UM-Battery-Control-Group/LDC_Dual_Can/README.md

# LDCquadCan
 can based LDC sensor

 Forgot to tie boot0 to ground so need to set nboot option in cube programmer
