UM-Battery-Control-Group/LDC_Dual_Can/GMJuly2022_CELL012_Test1_1_P25C_5P0PSI_20240211_R0_CH001.csv

Start Time: 1707704791028
Format Version: 3.0
Timezone: America/New_York
Channel Number: 1
[DATA START]
Datapoint Number | Test Time | Current | Potential | Timestamp | LDC SENSOR | LDC REF | Ambient Temperature | Ambient RH | LDC N | LDC STD | REF N | REF STD | LDC scaled | LDC status | REF status | DriveCurrent | DriveCurrentRef | NAHwarn | NAHwarnRef
none | second | amp | volt | epoch | none | none | celsius | percent | none | none | none | none | none | none | none | none | none | none | none
2 | 7.433 | 0 | 0 | 1707704798461 | 2418136 | 0 | 24.12 | 35.42 | 50 | 294 | 0 | 0 | 0 | 0 | 0 | 5 | 0 | 0 | 0
3 | 7.809 | 0 | 0 | 1707704798837 | 2418368 | 0 | 24.14 | 35.52 | 50 | 77 | 0 | 0 | 0 | 0 | 0 | 5 | 0 | 0 | 0
4 | 9.85 | 0 | 0 | 1707704800878 | 2418447 | 0 | 24.12 | 35.82 | 49 | 16 | 0 | 0 | 0 | 0 | 0 | 5 | 0 | 0 | 0
5 | 11.889 | 0 | 0 | 1707704802917 | 2418441 | 0 | 24.12 | 35.63 | 50 | 19 | 0 | 0 | 0 | 0 | 0 | 5 | 0 | 0 | 0
6 | 13.93 | 0 | 0 | 1707704804958 | 2418435 | 0 | 24.12 | 35.13 | 50 | 22 | 0 | 0 | 0 | 0 | 0 | 5 | 0 | 0 | 0
7 | 16.01 | 0 | 0 | 1707704807038 | 2409455 | 0 | 24.12 | 34.73 | 49 | 10 | 0 | 0 | 0 | 0 | 0 | 6 | 0 | 0 | 0
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
