UM-Battery-Control-Group/LDC_Dual_Can/GMJuly2022_CELL012_Test1_1_P25C_5P0PSI_20240213_R1_CH001.csv

Start Time: 1707871133780
Format Version: 3.0
Timezone: America/New_York
Channel Number: 1
[DATA START]
Datapoint Number | Test Time | Current | Potential | Timestamp | LDC SENSOR | LDC REF | Ambient Temperature | Ambient RH | LDC N | LDC STD | REF N | REF STD | LDC scaled | LDC status | REF status | DriveCurrent | DriveCurrentRef | NAHwarn | NAHwarnRef
none | second | amp | volt | epoch | none | none | celsius | percent | none | none | none | none | none | none | none | none | none | none | none
1 | 3.056 | 0 | 0 | 1707871136836 | 2668360 | 0 | 22.99 | 33.31 | 49 | 2 | 0 | 0 | 0 | 0 | 0 | 4 | 0 | 0 | 0
2 | 8.256 | 0 | 0 | 1707871142036 | 2668360 | 0 | 23.01 | 33.42 | 47 | 2 | 0 | 0 | 0 | 0 | 0 | 4 | 0 | 0 | 0
3 | 13.357 | 0 | 0 | 1707871147137 | 2668362 | 0 | 22.99 | 33.42 | 49 | 2 | 0 | 0 | 0 | 0 | 0 | 4 | 0 | 0 | 0
4 | 18.457 | 0 | 0 | 1707871152237 | 2668363 | 0 | 23.00 | 33.31 | 48 | 2 | 0 | 0 | 0 | 0 | 0 | 4 | 0 | 0 | 0
5 | 23.557 | 0 | 0 | 1707871157337 | 2668363 | 0 | 22.99 | 33.22 | 50 | 2 | 0 | 0 | 0 | 0 | 0 | 4 | 0 | 0 | 0
6 | 28.656 | 0 | 0 | 1707871162436 | 2668364 | 0 | 22.99 | 33.22 | 48 | 2 | 0 | 0 | 0 | 0 | 0 | 4 | 0 | 0 | 0
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
