UM-Battery-Control-Group/LDC_Dual_Can/GMJuly2022_CELL012_Test1_1_P25C_5P0PSI_20240215_R0_CH001.csv

Start Time: 1708018201816
Format Version: 3.0
Timezone: America/New_York
Channel Number: 1
[DATA START]
Datapoint Number | Test Time | Current | Potential | Timestamp | LDC SENSOR | LDC REF | Ambient Temperature | Ambient RH | LDC N | LDC STD | REF N | REF STD | LDC scaled | LDC status | REF status | DriveCurrent | DriveCurrentRef | NAHwarn | NAHwarnRef
none | second | amp | volt | epoch | none | none | celsius | percent | none | none | none | none | none | none | none | none | none | none | none
1 | 2.364 | 0 | 0 | 1708018204180 | 2669191 | 0 | 22.96 | 33.61 | 49 | 1 | 0 | 0 | 0 | 0 | 0 | 4 | 0 | 0 | 0
2 | 7.363 | 0 | 0 | 1708018209179 | 2669192 | 0 | 22.99 | 33.51 | 50 | 1 | 0 | 0 | 0 | 0 | 0 | 4 | 0 | 0 | 0
3 | 12.364 | 0 | 0 | 1708018214180 | 2669193 | 0 | 22.97 | 33.72 | 48 | 2 | 0 | 0 | 0 | 0 | 0 | 4 | 0 | 0 | 0
4 | 17.364 | 0 | 0 | 1708018219180 | 2669194 | 0 | 23.00 | 33.61 | 50 | 1 | 0 | 0 | 0 | 0 | 0 | 4 | 0 | 0 | 0
5 | 22.46 | 0 | 0 | 1708018224276 | 2669197 | 0 | 23.00 | 33.42 | 50 | 2 | 0 | 0 | 0 | 0 | 0 | 4 | 0 | 0 | 0
6 | 27.46 | 0 | 0 | 1708018229276 | 2669196 | 0 | 22.99 | 33.42 | 50 | 2 | 0 | 0 | 0 | 0 | 0 | 4 | 0 | 0 | 0
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
