UM-Battery-Control-Group/LDC_Dual_Can/Schematic.PDF

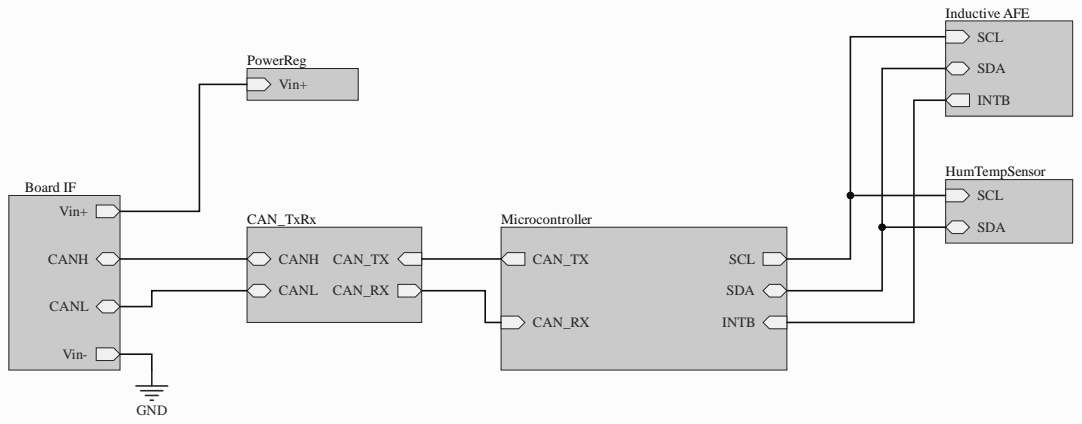
[picture p1: page 1]

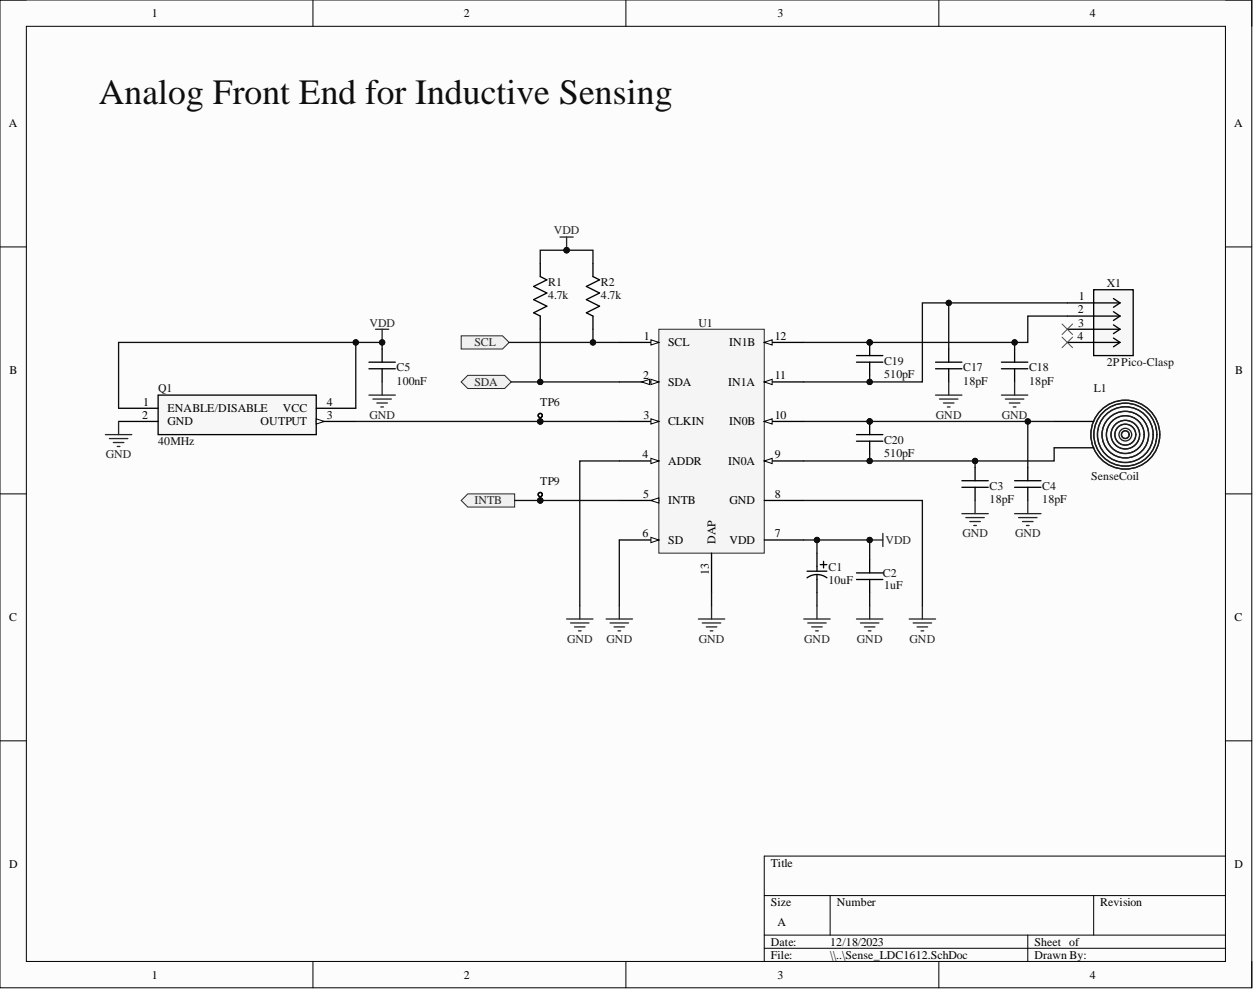
[picture p2: page 2]

Analog Front End for Inductive Sensing

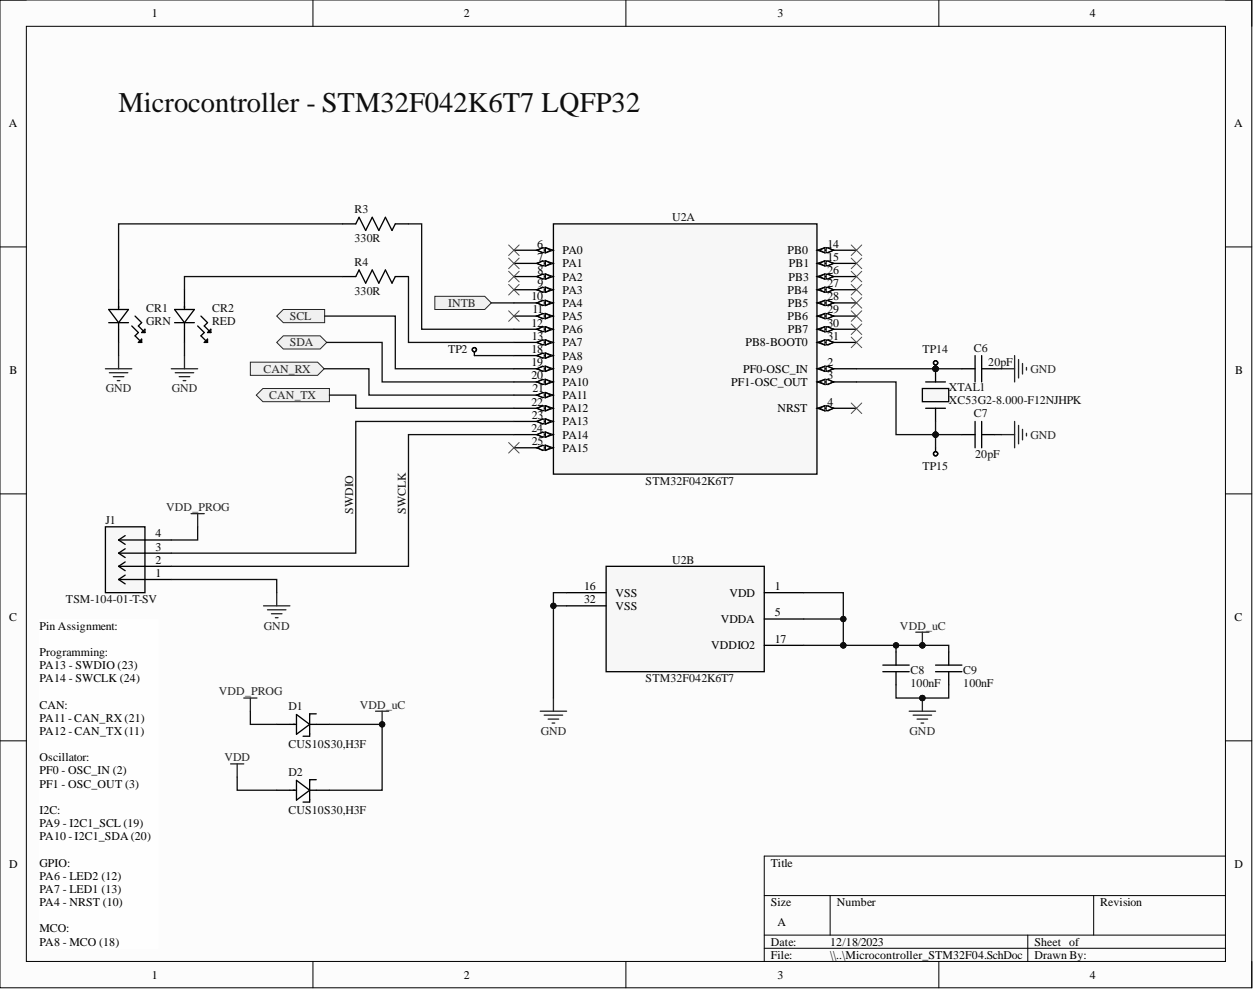
[picture p3: page 3]

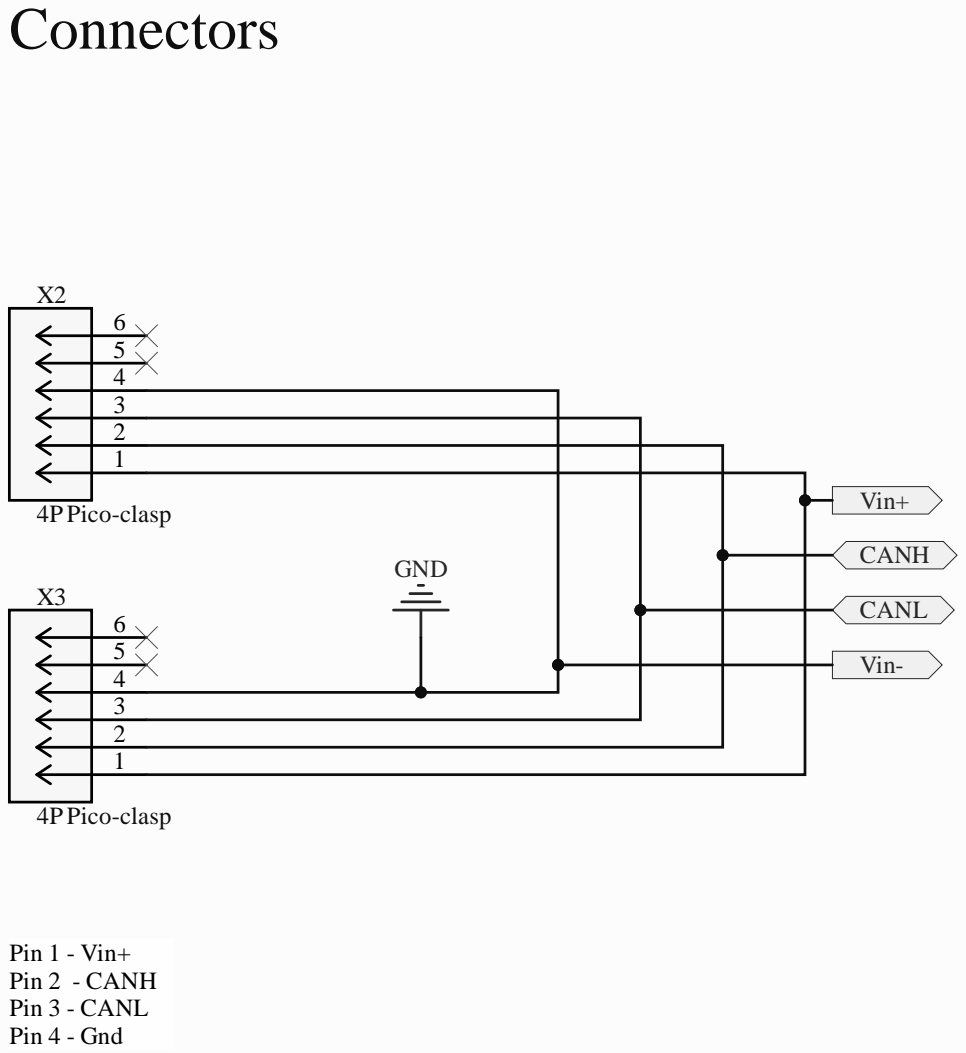
[picture p4: page 4]

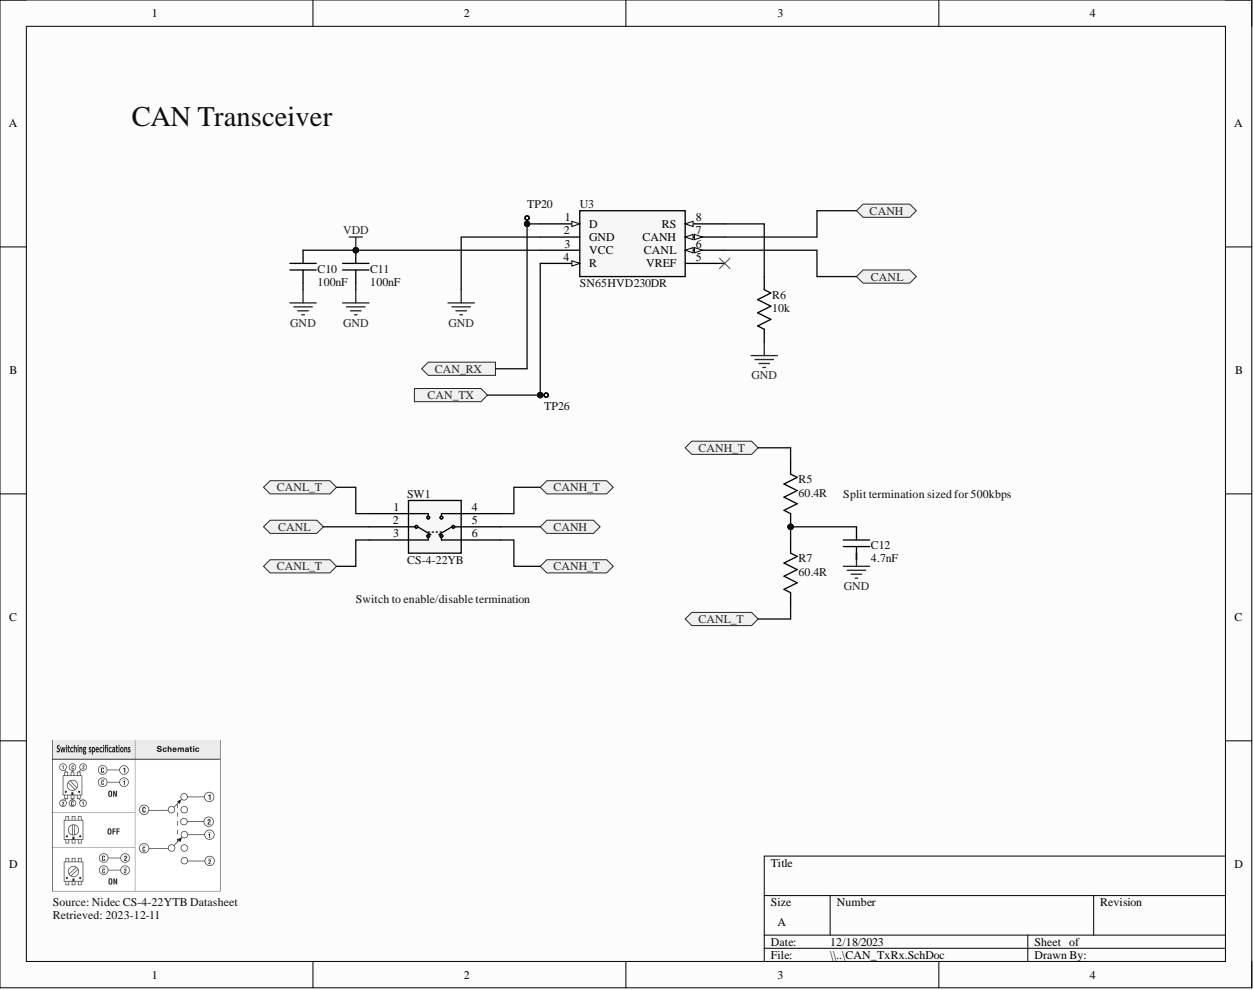
[picture p5: page 5]

Split termination sized for 500kbps

Switch to enable/disable termination

Source: Nidec CS-4-22YTB Datasheet
Retrieved: 2023-12-11

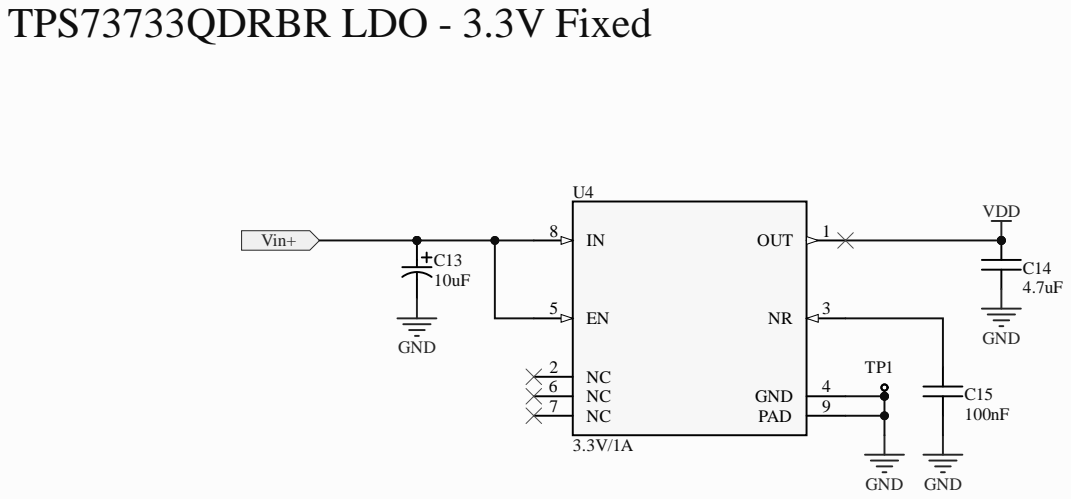
[picture p6: page 6]

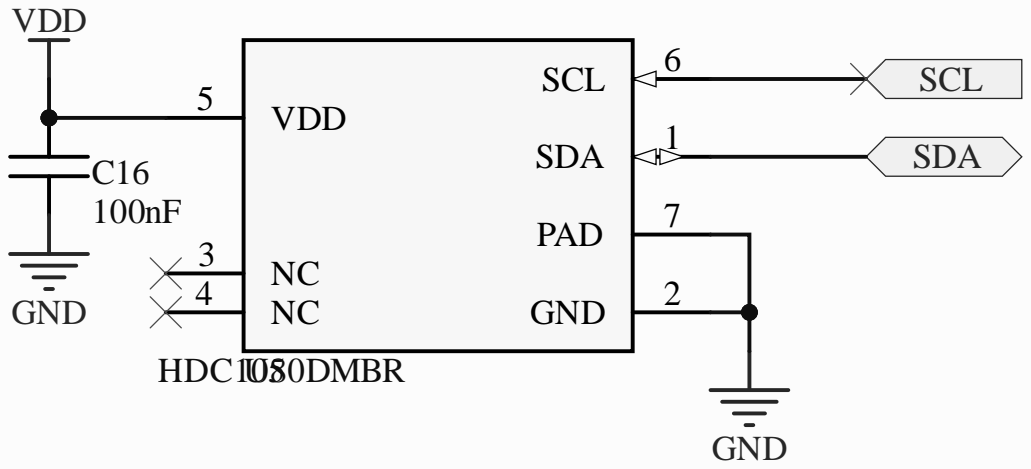
[picture p7: page 7]
