UM-Battery-Control-Group/LDC_Dual_Can/(list of files, drawings)

Other design files:
L_Sense_Board_Rev3.2/Shared_Libraries/Schlib1.SchLib
