UM-Battery-Control-Group/LDC_Dual_Can/L_Sense_Board_Rev3.2/InductiveSensor_LDC1612_Rev3.2/InductiveSensor_LDC1612_Rev3.2.kicad_pcb

## KiCad design L_Sense_Board_Rev3.2/InductiveSensor_LDC1612_Rev3.2/InductiveSensor_LDC1612_Rev3.2.kicad_pcb (2026-05-11)

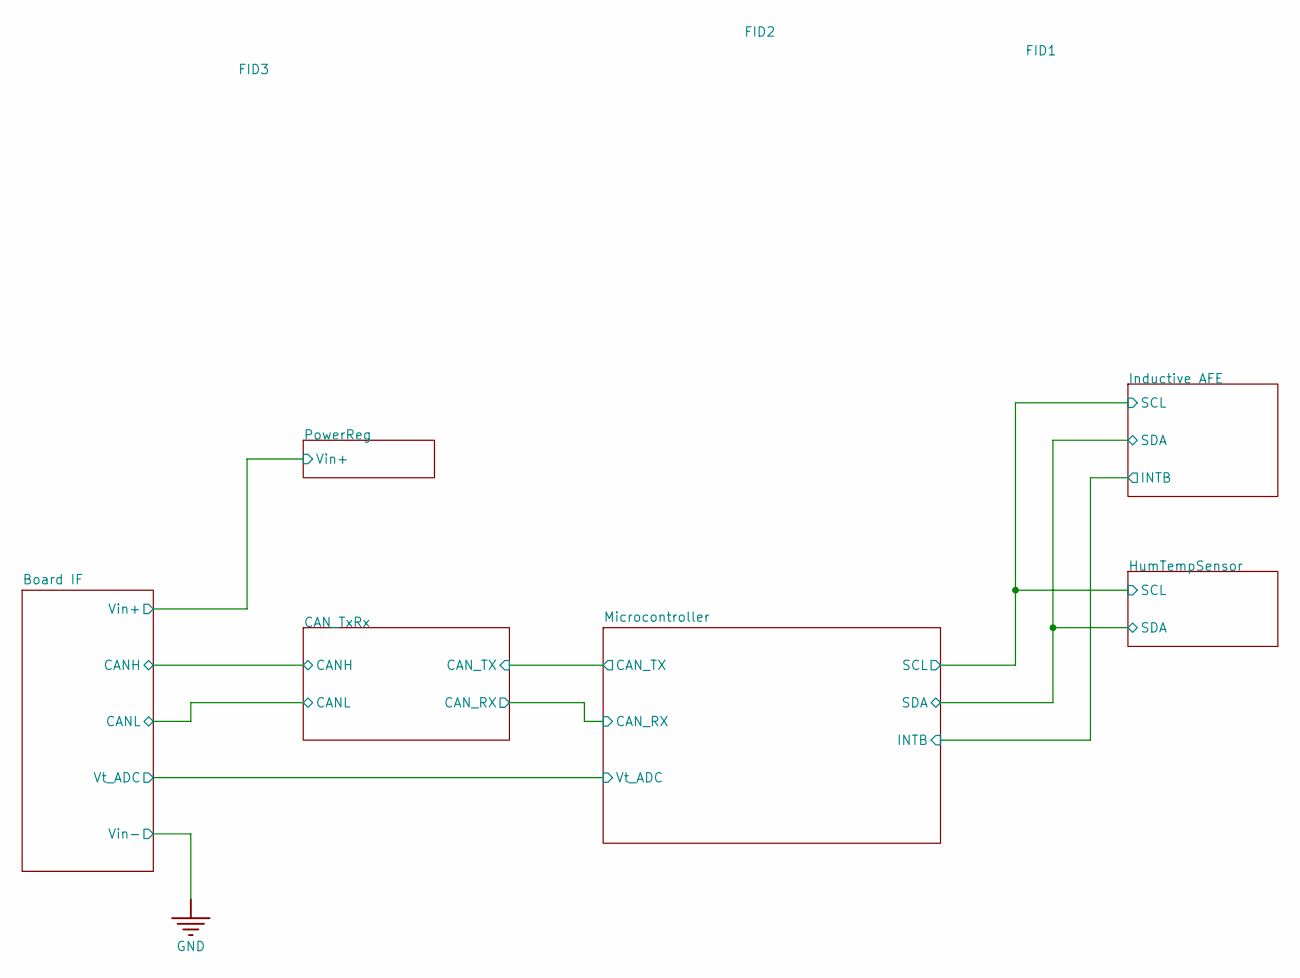
[picture p8: schematic Sheet1.kicad_sch]

Parts:
FID1, FID2, FID3: Fiducial; FID

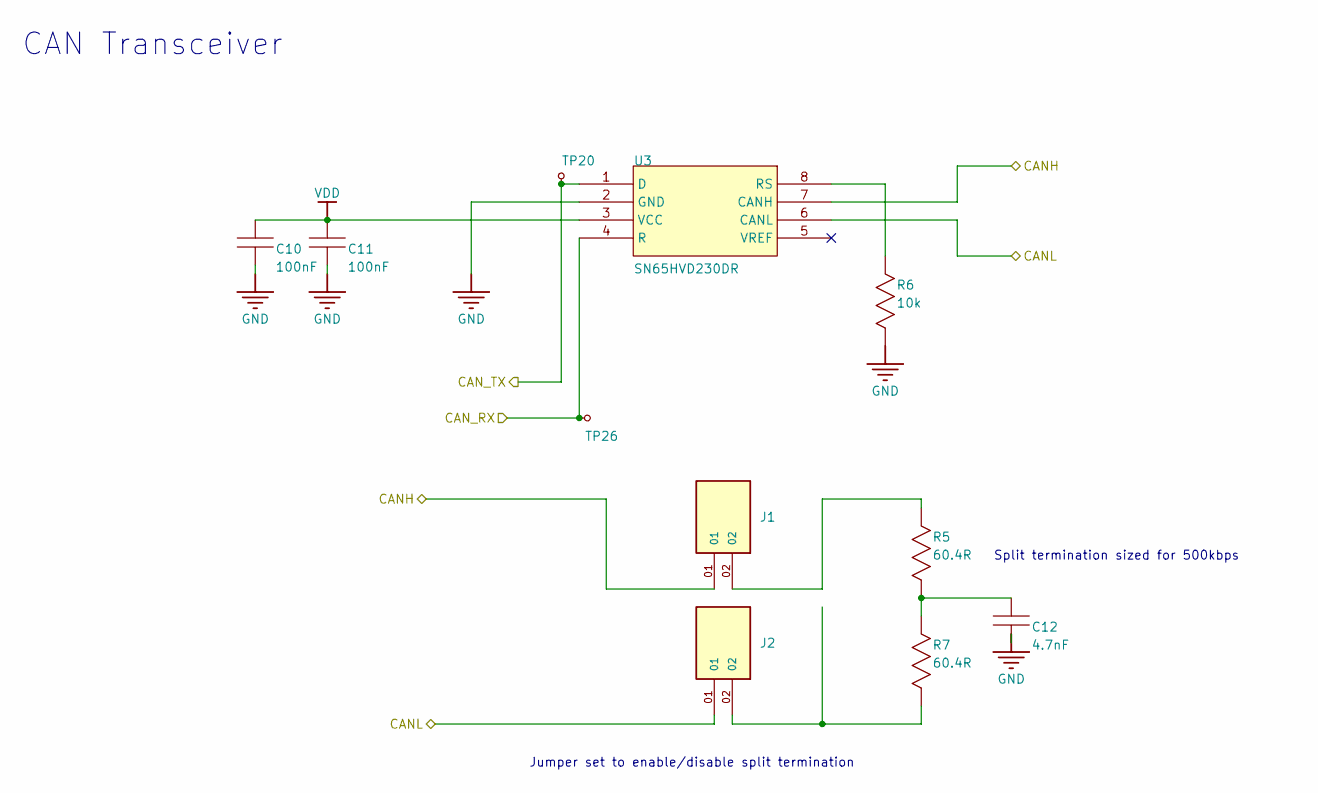
[picture p9: schematic CAN_TxRx.kicad_sch]

Parts:
C10, C11: 100nF; CAP0805; TOLERANCE 10%; VOLTAGE 50V; MANUFACTURER PART NUMBER CC0805KRX7R9BB104; LCSC PART# C49678
C12: 4.7nF; C0603; MANUFACTURER PART NUMBER C0603C472K1TACAUTO; LCSC PART# C3882427
J1, J2: TSM-102-01-X-SV; SAMTEC_TSM-102-01-X-SV; PARTREV D; DigiKey_Part_Number 612-TSM-102-01-S-SV-P-TRCT-ND
R5, R7: 60.4R; R0603; POWER RATING 100mW; TOLERANCE 1%; MANUFACTURER PART NUMBER RC0603FR-0760R4L; LCSC PART# C245987
R6: 10k; R0603; TOLERANCE 1%; VOLTAGE RATING (AC) 50V; MANUFACTURER PART NUMBER RC0603FR-0710KL; LCSC PART# C98220
TP20, TP26: 1mm Test Point; TP_1MM
U3: SN65HVD230DR; SOIC_8; MANUFACTURER PART NUMBER SN65HVD230DR; LCSC PART# C12084

Connections:
//Board IF/CANH: J1.01, U3.7 (CANH); also elsewhere on the board
//Board IF/CANL: J2.01, U3.6 (CANL); also elsewhere on the board
//CAN_TxRx/CAN_RX: TP26.1 (0), U3.4 (R); also elsewhere on the board
//CAN_TxRx/CAN_TX: TP20.1 (0), U3.1 (D); also elsewhere on the board
GND: C10.2, C11.2, C12.2, R6.2, U3.2 (GND); also elsewhere on the board
unnamed: C12.1, R5.2, R7.1
unnamed: J1.02, R5.1
unnamed: J2.02, R7.2
unnamed: R6.1, U3.8 (RS)
VDD: C10.1, C11.1, U3.3 (VCC); also elsewhere on the board

Notes on the sheet:
CAN Transceiver
Split termination sized for 500kbps
Jumper set to enable/disable split termination

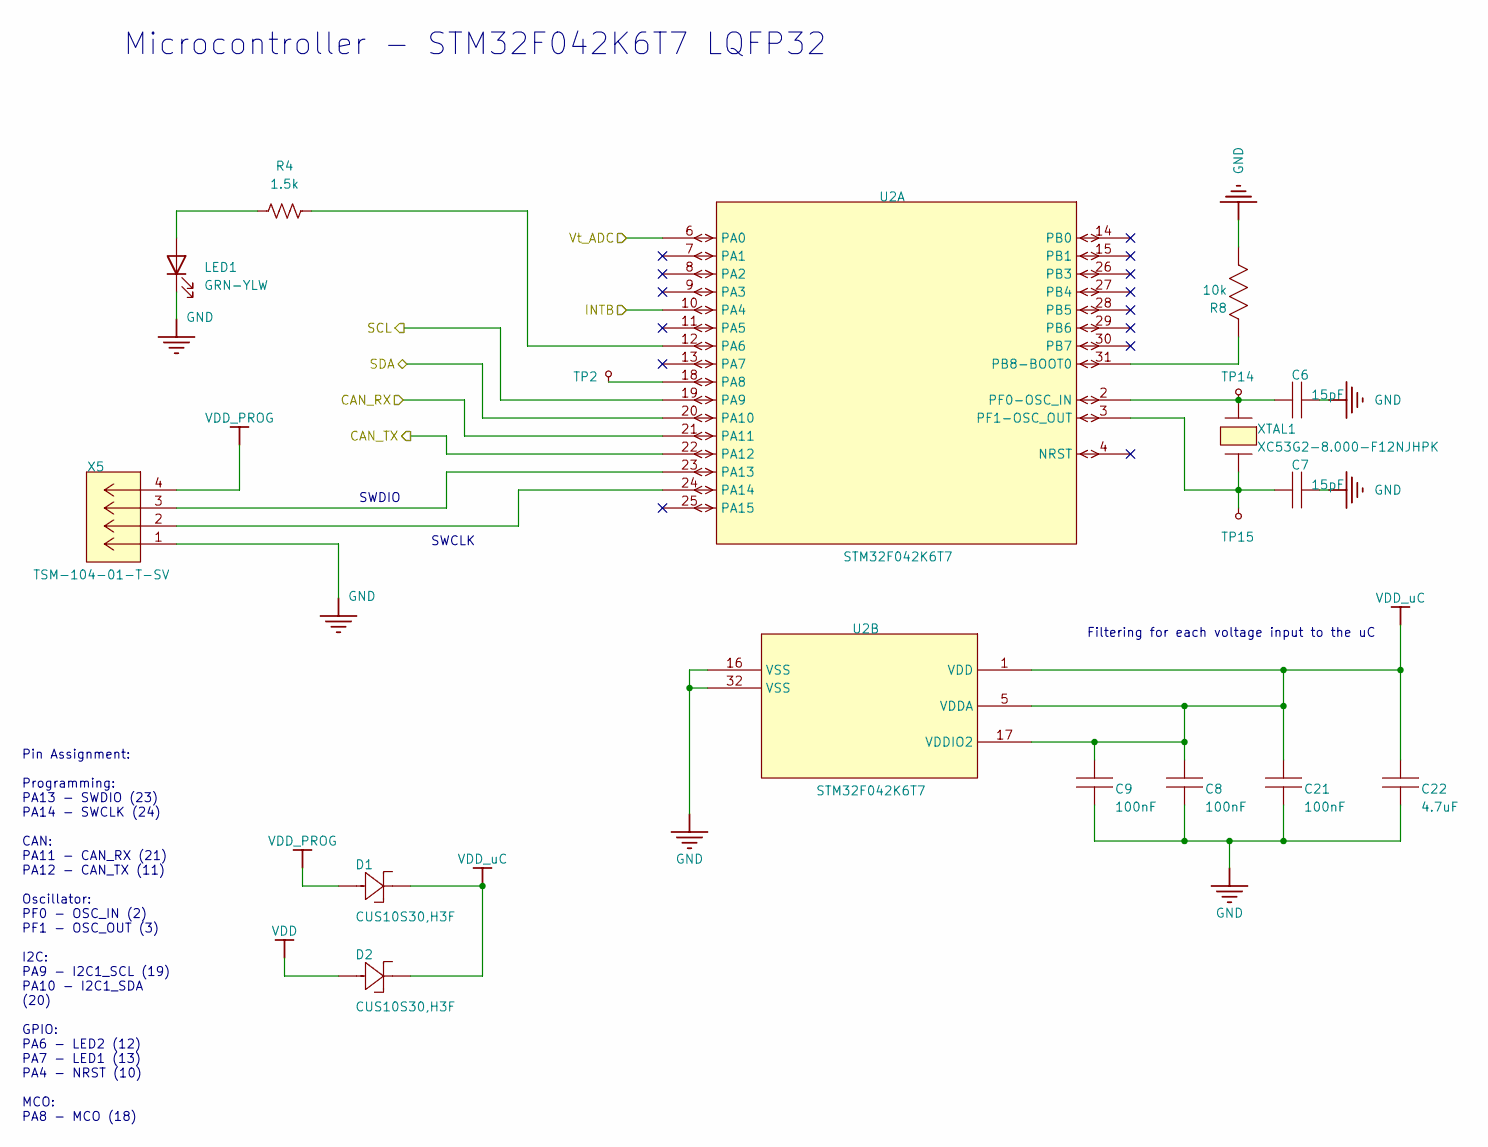
[picture p10: schematic Microcontroller_STM32F04.kicad_sch]

Parts:
C6, C7: 15pF; C0603; TOLERANCE 5%; VOLTAGE RATING 50V; MANUFACTURER PART NUMBER CL10C150JB81PNC
C8, C9, C21: 100nF; CAP0805; TOLERANCE 10%; VOLTAGE 50V; MANUFACTURER PART NUMBER CC0805KRX7R9BB104; LCSC PART# C49678
C22: 4.7uF; C_1206_3216Metric; TOLERANCE 10%; VOLTAGE 50V; MANUFACTURER PART NUMBER CC1206KFX7R9BB475
D1, D2: CUS10S30,H3F; USC_TOS; MANUFACTURER_PART_NUMBER CUS10S30,H3F; LCSC PART# C146335
LED1: GRN-YLW; LED_0603_1608Metric; MPN 5988E60107F
R4: 1.5k; R_0603_1608Metric; Part Number RC0603FR-7W1K5L
R8: 10k; R0603; TOLERANCE 1%; VOLTAGE RATING (AC) 50V; MANUFACTURER PART NUMBER RC0603FR-0710KL; LCSC PART# C98220
TP2, TP14, TP15: 1mm Test Point; TP_1MM
U2: STM32F042K6T7; LQFP-32; MANUFACTURER_PART_NUMBER STM32F042K6T7; LCSC PART# C1337340
X5: TSM-104-01-T-SV; CONN_TSM-104-01-T-SV_SAI; MAX VOLTAGE RATING (AC) 475V; FLAMMABILITY RATING UL94 V-0; MANUFACTURER_PART_NUMBER TSM-104-01-T-SV; LCSC PART# C3335977
XTAL1: XC53G2-8.000-F12NJHPK; XTAL_NX5032_NDK; MANUFACTURER_PART_NUMBER XC53G2-8.000-F12NJHPK; LCSC PART# C2842269

Connections:
//Board IF/Vt_ADC: U2.6 (PA0); also elsewhere on the board
//CAN_TxRx/CAN_RX: U2.21 (PA11); also elsewhere on the board
//CAN_TxRx/CAN_TX: U2.22 (PA12); also elsewhere on the board
//HumTempSensor/SCL: U2.19 (PA9); also elsewhere on the board
//HumTempSensor/SDA: U2.20 (PA10); also elsewhere on the board
//Inductive AFE/INTB: U2.10 (PA4); also elsewhere on the board
GND: C6.1, C7.1, C8.2, C9.2, C21.2, C22.2, LED1.1 (K), R8.2, U2.16 (VSS), U2.32 (VSS), X5.1; also elsewhere on the board
unnamed: LED1.2 (A), R4.1
unnamed: TP2.1 (0), U2.18 (PA8)
unnamed: C6.2, TP14.1 (0), U2.2 (PF0-OSC_IN), XTAL1.2
unnamed: C7.2, TP15.1 (0), U2.3 (PF1-OSC_OUT), XTAL1.1
unnamed: R4.2, U2.12 (PA6)
unnamed: U2.23 (PA13), X5.3
unnamed: U2.24 (PA14), X5.2
unnamed: R8.1, U2.31 (PB8-BOOT0)
VDD: D2.2 (anode); also elsewhere on the board
VDD_PROG: D1.2 (anode), X5.4
VDD_uC: C8.1, C9.1, C21.1, C22.1, D1.1 (cathode), D2.1 (cathode), U2.1 (VDD), U2.5 (VDDA), U2.17 (VDDIO2); also elsewhere on the board

Notes on the sheet:
SWDIO
Microcontroller - STM32F042K6T7 LQFP32
SWCLK
Filtering for each voltage input to the uC
Pin Assignment: Programming: PA13 - SWDIO (23) PA14 - SWCLK (24) CAN: PA11 - CAN_RX (21) PA12 - CAN_TX (11) Oscillator: PF0 - OSC_IN (2) PF1 - OSC_OUT (3) I2C: PA9 - I2C1_SCL (19) PA10 - I2C1_SDA (20) GPIO: PA6 - LED2 (12) PA7 - LED1 (13) PA4 - NRST (10) MCO: PA8 - MCO (18)

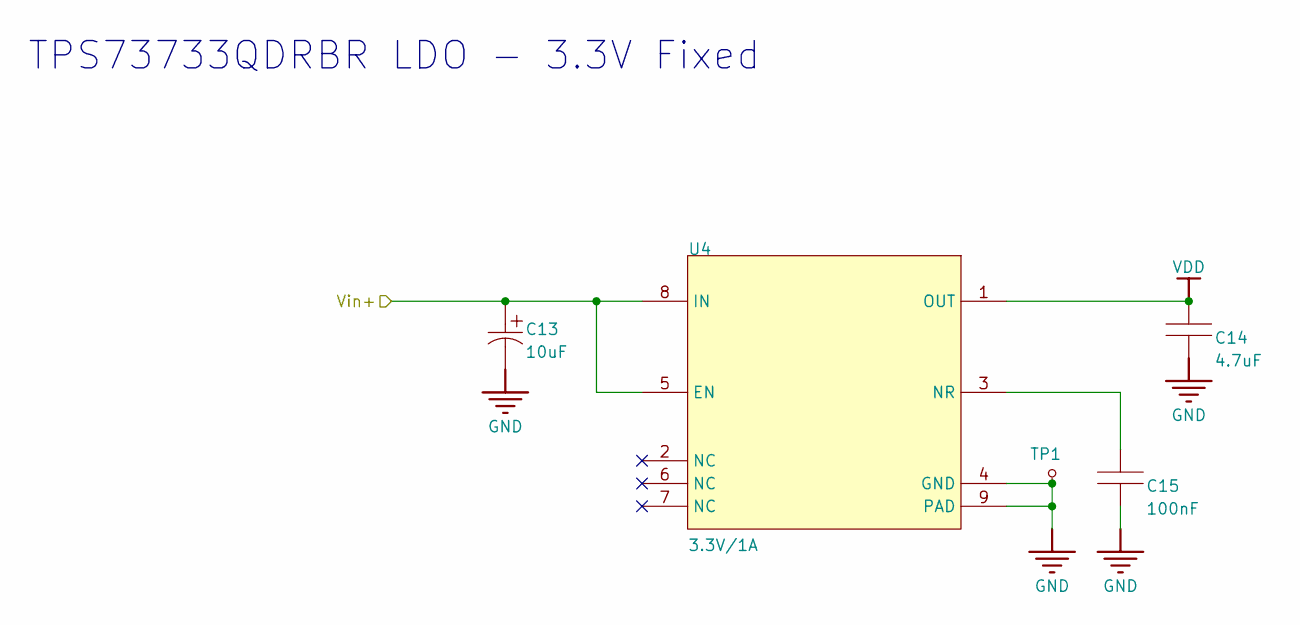
[picture p11: schematic PowerReg.kicad_sch]

Parts:
C13: 10uF; CAP1206_TAJA; TOLERANCE 10%; VOLTAGE RATING 16V; MANUFACTURER_PART_NUMBER TAJA106K016RNJ; LCSC PART# C7171
C14: 4.7uF; CAP0805; TOLERANCE 10%; VOLTAGE RATING 25V; MANUFACTURER PART NUMBER CL21A475KAQNNNE; LCSC PART# C1779
C15: 100nF; CAP0805; TOLERANCE 10%; VOLTAGE 50V; MANUFACTURER PART NUMBER CC0805KRX7R9BB104; LCSC PART# C49678
TP1: 1mm Test Point; TP_1MM
U4: 3.3V/1A; VSON_DRB8; OUTPUT VOLTAGE 3.3V; DROPOUT VOLTAGE 130mV; MANUFACTURER PART NUMBER TPS73733QDRBRQ1; LCSC PART# C523768

Connections:
//Board IF/Vin+: C13.1, U4.5 (EN), U4.8 (IN); also elsewhere on the board
GND: C13.2, C14.1, C15.2, TP1.1 (0), U4.4 (GND), U4.9 (PAD); also elsewhere on the board
unnamed: C15.1, U4.3 (NR)
VDD: C14.2, U4.1 (OUT); also elsewhere on the board

Notes on the sheet:
TPS73733QDRBR LDO - 3.3V Fixed

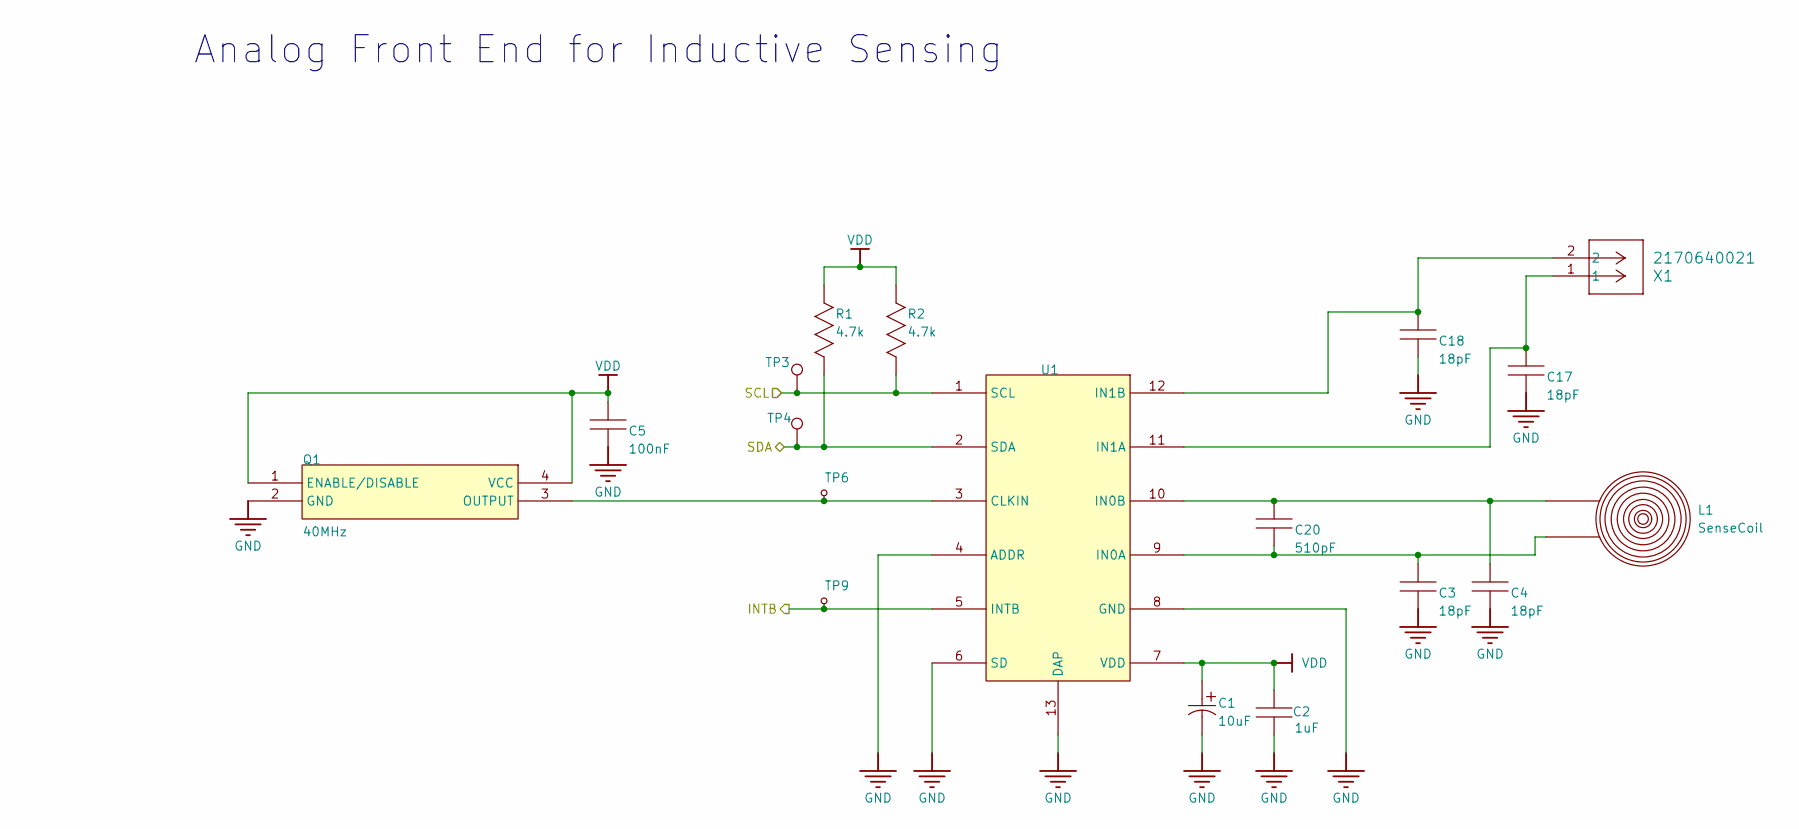
[picture p12: schematic Sense_LDC1612.kicad_sch]

Parts:
C1: 10uF; CAP1206_TAJA; TOLERANCE 10%; VOLTAGE RATING 16V; MANUFACTURER_PART_NUMBER TAJA106K016RNJ; LCSC PART# C7171
C2: 1uF; CAP0805; TOLERANCE 10%; VOLTAGE RATING 50V; MANUFACTURER PART NUMBER CL21B105KBFNNNE; LCSC PART# C28323
C3, C4, C17, C18: 18pF; CAP0805; TOLERANCE 5%; VOLTAGE RATING 50V; MANUFACTURER PART NUMBER VJ0805A180JXACW1BC; LCSC PART# C2174299
C5: 100nF; CAP0805; TOLERANCE 10%; VOLTAGE 50V; MANUFACTURER PART NUMBER CC0805KRX7R9BB104; LCSC PART# C49678
C20: 510pF; CAP0805; TOLERANCE 5%; VOLTAGE RATING (DC) 50V; MANUFACTURER PART NUMBER CC0805JRNPO9BN511; LCSC PART# C309486
L1: SenseCoil; COIL_4L
Q1: 40MHz; KC2520Z_KYO; MANUFACTURER PART NUMBER KC2520Z40.0000C15XXK; LCSC PART# C1857241
R1, R2: 4.7k; RES0805; TOLERANCE 5%; POWER RATING 125mW; MANUFACTURER PART NUMBER ERJ-6GEYJ472V; LCSC PART# C230645
TP3, TP4: TestPoint; TP_1MM
TP6, TP9: 1mm Test Point; TP_1MM
U1: Inductive Sensor 2Ch; LDC1612; MANUFACTURER PART NUMBER LDC1612DNTR; LCSC PART# C1847959
X1: 2170640021; CONN_2170630000-SD_02_MOL; MANUFACTURER PART NUMBER 2170640021

Connections:
//HumTempSensor/SCL: R2.2, TP3.1, U1.1 (SCL); also elsewhere on the board
//HumTempSensor/SDA: R1.2, TP4.1, U1.2 (SDA); also elsewhere on the board
//Inductive AFE/INTB: TP9.1 (0), U1.5 (INTB); also elsewhere on the board
GND: C1.2, C2.2, C3.2, C4.2, C5.2, C17.2, C18.2, Q1.2 (GND), U1.4 (ADDR), U1.6 (SD), U1.8 (GND), U1.13 (DAP); also elsewhere on the board
unnamed: Q1.3 (OUTPUT), TP6.1 (0), U1.3 (CLKIN)
unnamed: C3.1, C20.1, L1.1, U1.9 (IN0A)
unnamed: C4.1, C20.2, L1.2, U1.10 (IN0B)
unnamed: C17.1, U1.11 (IN1A), X1.1
unnamed: C18.1, U1.12 (IN1B), X1.2
VDD: C1.1, C2.1, C5.1, Q1.1 (ENABLE/DISABLE), Q1.4 (VCC), R1.1, R2.1, U1.7 (VDD); also elsewhere on the board

Notes on the sheet:
Analog Front End for Inductive Sensing

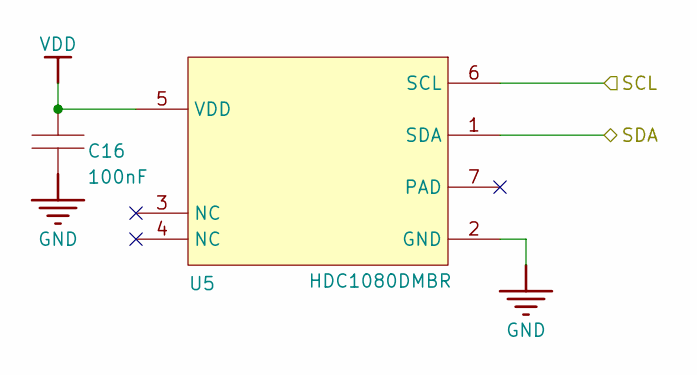
[picture p13: schematic HumTempSensor.kicad_sch]

Parts:
C16: 100nF; CAP0805; TOLERANCE 10%; VOLTAGE 50V; MANUFACTURER PART NUMBER CC0805KRX7R9BB104; LCSC PART# C49678
U5: I2C Humidity/Temp Sensor; WSON_DMB6; MANUFACTURER PART NUMBER HDC1080DMBR; LCSC PART# C82227

Connections:
//HumTempSensor/SCL: U5.6 (SCL); also elsewhere on the board
//HumTempSensor/SDA: U5.1 (SDA); also elsewhere on the board
GND: C16.2, U5.2 (GND); also elsewhere on the board
VDD: C16.1, U5.5 (VDD); also elsewhere on the board

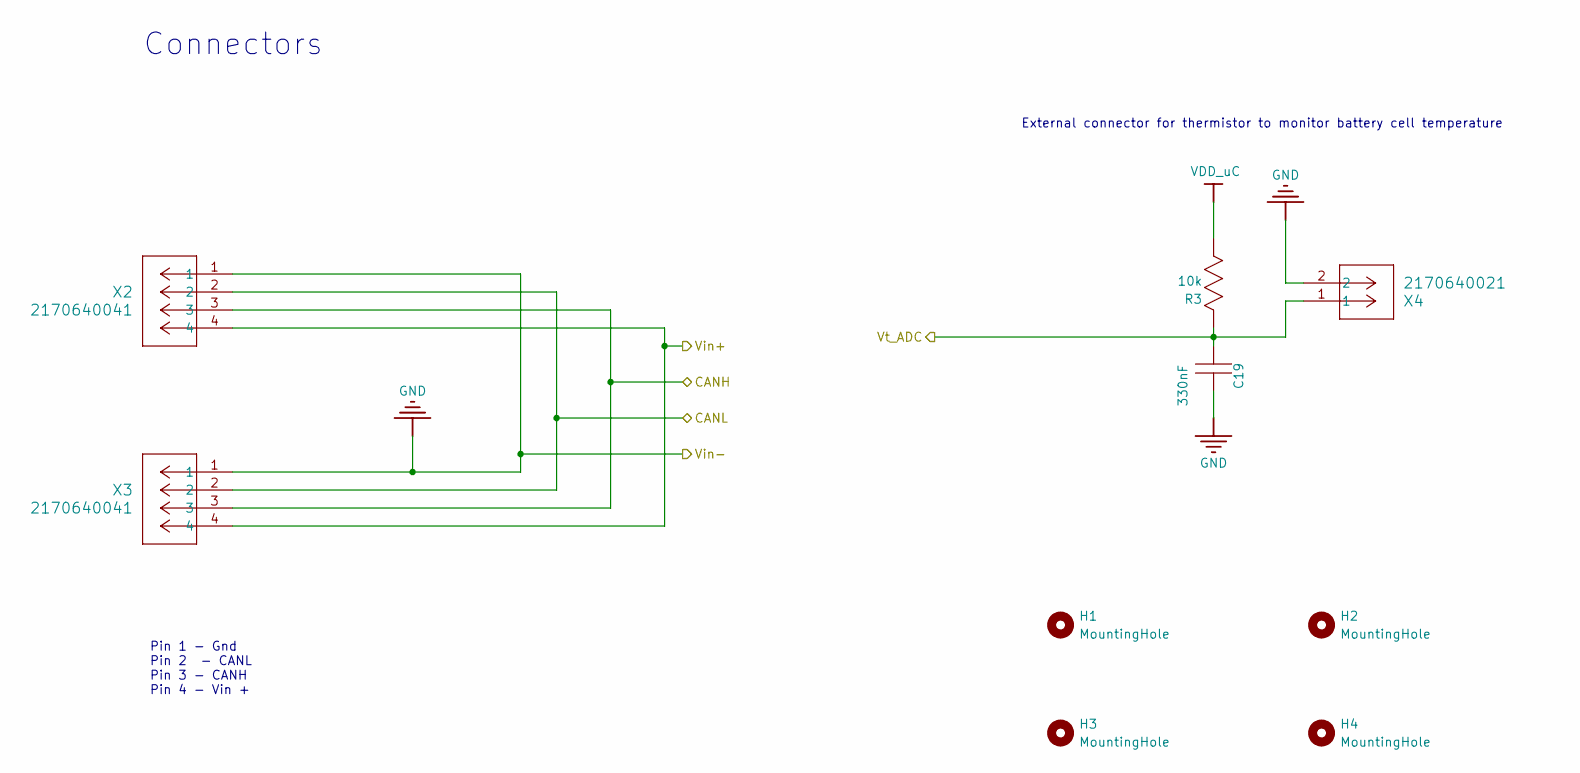
[picture p14: schematic BoardIF.kicad_sch]

Parts:
C19: 330nF; C0603; VOLTAGE RATING 50V; VOLTAGE 50V; MANUFACTURER PART NUMBER 0603B334K500XD
H1, H2, H3, H4: MountingHole; MountingHole_3.2mm_M3
R3: 10k; R0603; TOLERANCE 1%; VOLTAGE RATING (AC) 50V; MANUFACTURER PART NUMBER RC0603FR-0710KL; LCSC PART# C98220
X2, X3: 2170640041; CONN_2170630000-SD_04_MOL; MANUFACTURER PART NUMBER 2170640041
X4: 2170640021; CONN_2170630000-SD_02_MOL; MANUFACTURER PART NUMBER 2170640021

Connections:
//Board IF/CANH: X2.3, X3.3; also elsewhere on the board
//Board IF/CANL: X2.2, X3.2; also elsewhere on the board
//Board IF/Vin+: X2.4, X3.4; also elsewhere on the board
//Board IF/Vt_ADC: C19.2, R3.1, X4.1; also elsewhere on the board
GND: C19.1, X2.1, X3.1, X4.2; also elsewhere on the board
VDD_uC: R3.2; also elsewhere on the board

Notes on the sheet:
External connector for thermistor to monitor battery cell temperature
Connectors
Pin 1 - Gnd Pin 2 - CANL Pin 3 - CANH Pin 4 - Vin +

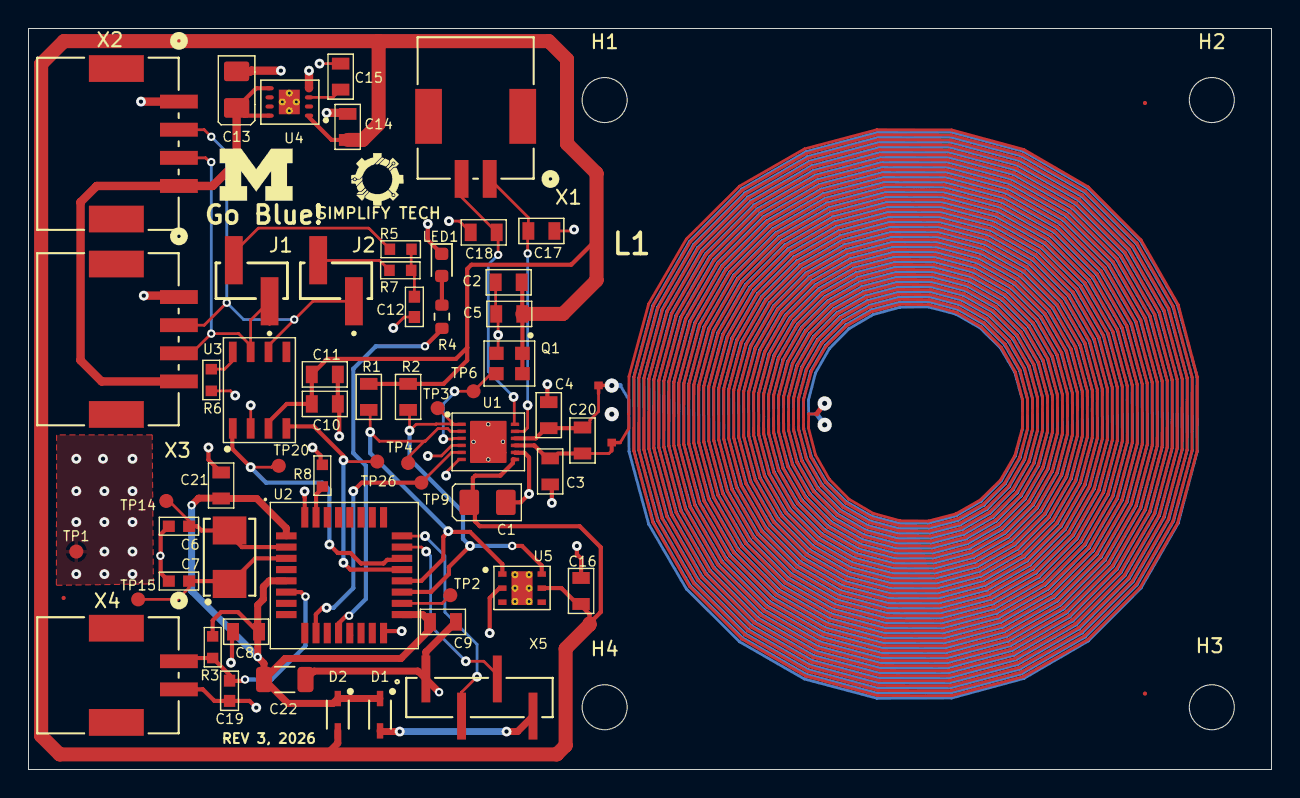
[picture p15: board InductiveSensor_LDC1612_Rev3.2.kicad_pcb from above]

Board: 4 copper layers, 88.4 x 52.7 mm, 65 parts (0 on the bottom side), 31 nets.
