UM-Battery-Control-Group/LDC_Dual_Can/L_Sense_Board_Rev3.2/Off_board_Inductor/Off_board_Inductor.kicad_pcb

## KiCad design L_Sense_Board_Rev3.2/Off_board_Inductor/Off_board_Inductor.kicad_pcb (2026-05-11)

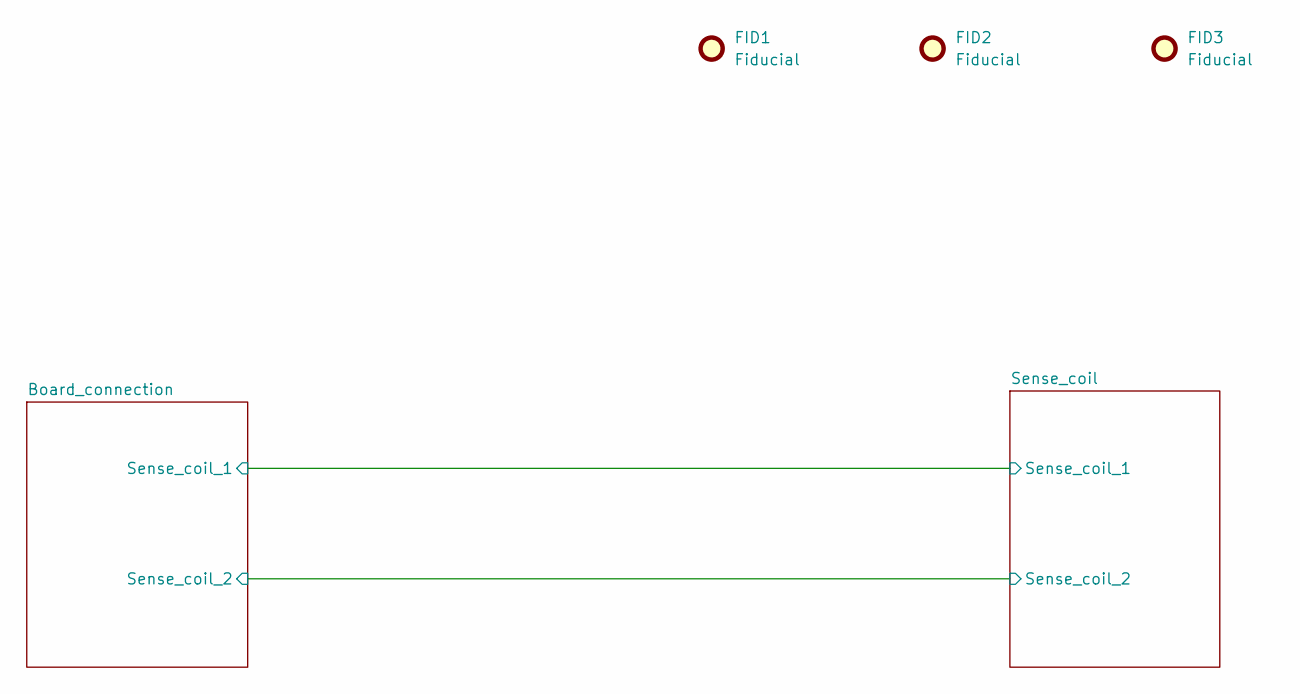
[picture p16: schematic Off_board_setup.kicad_sch]

Parts:
FID1, FID2, FID3: Fiducial; FID

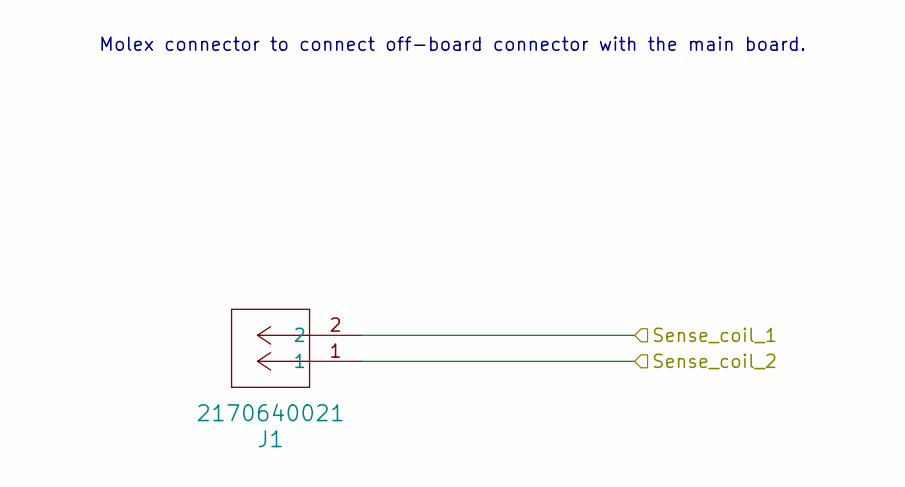
[picture p17: schematic Board_connection.kicad_sch]

Parts:
J1: 2170640021; CONN_2170630000-SD_02_MOL

Connections:
/Off_board_inductor/Board_connection/Sense_coil_1: J1.2; also elsewhere on the board
/Off_board_inductor/Board_connection/Sense_coil_2: J1.1; also elsewhere on the board

Notes on the sheet:
Molex connector to connect off-board connector with the main board.

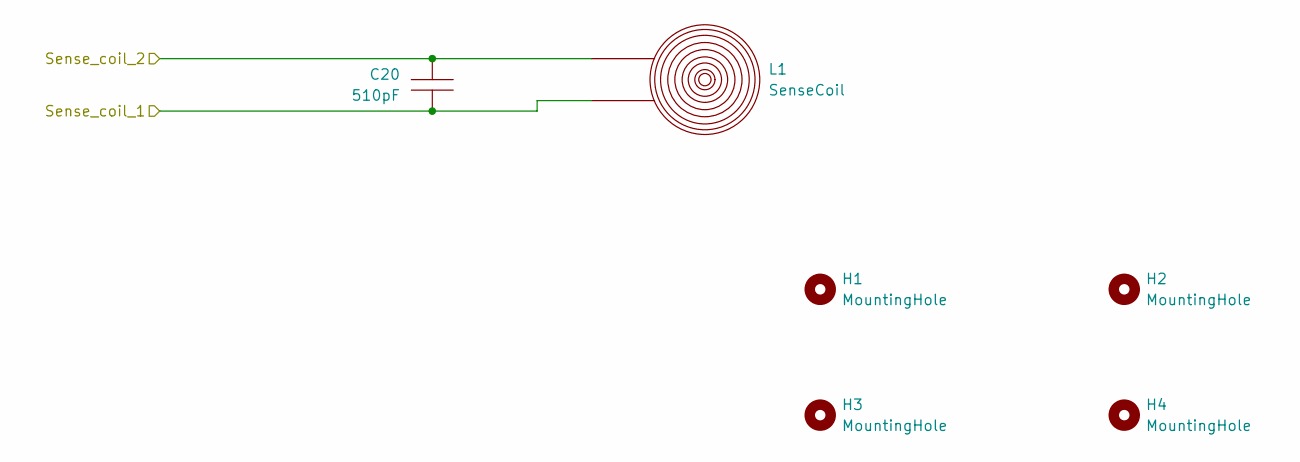
[picture p18: schematic Sense_coil.kicad_sch]

Parts:
C20: 510pF; CAP0805; TOLERANCE 5%; VOLTAGE RATING (DC) 50V; MANUFACTURER PART NUMBER CC0805JRNPO9BN511
H1, H2, H3, H4: MountingHole; MountingHole_3.2mm_M3
L1: SenseCoil; COIL_4L

Connections:
/Off_board_inductor/Board_connection/Sense_coil_1: C20.1, L1.1; also elsewhere on the board
/Off_board_inductor/Board_connection/Sense_coil_2: C20.2, L1.2; also elsewhere on the board

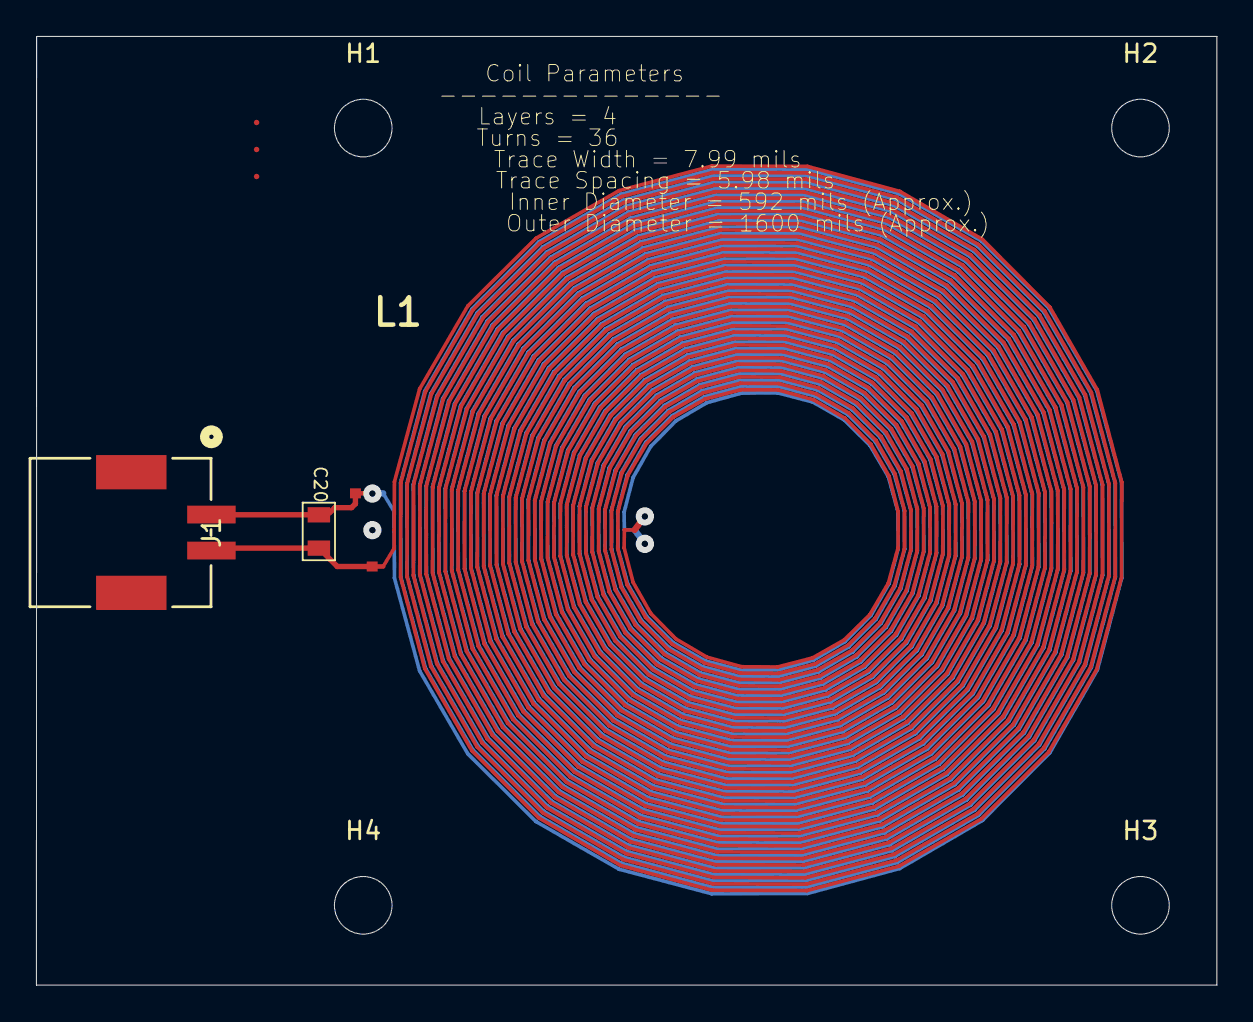
[picture p19: board Off_board_Inductor.kicad_pcb from above]

Board: 4 copper layers, 65.6 x 52.7 mm, 10 parts (0 on the bottom side), 2 nets.
