UM-Battery-Control-Group/LDC_Dual_Can/LDC_Dual_Cal.ioc

Mcu.UserName=STM32F042K6Tx
PA0.Signal=ADC_IN0
PA10.Signal=I2C1_SDA
PA11.Signal=CAN_RX
PA12.Signal=CAN_TX
PA13.Signal=SYS_SWDIO
PA14.Signal=SYS_SWCLK
PA4.Signal=GPXTI4
PA6.Signal=GPIO_Output
PA7.Signal=GPIO_Output
PA9.Signal=I2C1_SCL
PF0-OSC_IN.Signal=RCC_OSC_IN
PF1-OSC_OUT.Signal=RCC_OSC_OUT
