UM-Battery-Control-Group/LDC_Dual_Can/(commit log)

2024-01-08 fist pass
    can blink an LED>
    [Bill of Materials-Coil.xlsx, Bill of Materials-InductiveSensor_LDC1612.xlsx, BoardIF.SchDoc, Board_with_LDC1614_no_ind_blink_V4.brd, Board_with_LDC1614_no_ind_blink_V4.sch, Board_with_LDC1614_no_ind_blink_V4_top_bom.csv, CAN_TxRx.SchDoc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]
2024-01-26 tested working code for new Dual channel boards
    Need to check LDC configuration, and timing. but tested and seems to work,
    Using timer channel 3 for interrupt based sampling of the board.
    [Board_with_LDC1614_no_ind_blink_V4.brd, Board_with_LDC1614_no_ind_blink_V4.sch, Board_with_LDC1614_no_ind_blink_V4_top_bom.csv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]
2024-02-12 updated code with can interrupts enabled
    [GMJuly2022_CELL012_Test1_1_P25C_5P0PSI_20240211_R0_CH001.csv, GMJuly2022_CELL015_Test1_1_P25C_5P0PSI_20240211_R0_CH002.csv, drive_current.csv]
2024-02-14 more changes to local files
    agh
    [GMJuly2022_CELL012_Test1_1_P25C_5P0PSI_20240213_R0_CH001.csv, GMJuly2022_CELL015_Test1_1_P25C_5P0PSI_20240213_R0_CH002.csv, LDC_Tools-ext51_Configured_1612_4layer.xlsx, test_CH002.csv, testch1.csv]
2024-02-15 fix sampling rate and N=50 samples
    fix sampling rate issue and N=50, potential overflow bug.
    [GMJuly2022_CELL012_Test1_1_P25C_5P0PSI_20240213_R0_CH001.csv, GMJuly2022_CELL012_Test1_1_P25C_5P0PSI_20240213_R1_CH001.csv, GMJuly2022_CELL012_Test1_1_P25C_5P0PSI_20240215_R0_CH001.csv, GMJuly2022_CELL015_Test1_1_P25C_5P0PSI_20240213_R0_CH002.csv, GMJuly2022_CELL015_Test1_1_P25C_5P0PSI_20240213_R1_CH002.csv, GMJuly2022_CELL015_Test1_1_P25C_5P0PSI_20240215_R0_CH002.csv, LDC_Tools-ext51_Configured_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]
2026-05-11 Remove V1 board hardware and Add Ver 3.2 board hardware
    Remove V1 board hardware and Add Ver 3.2 board hardware
    [Bill of Materials-Coil.xlsx, Bill of Materials-InductiveSensor_LDC1612.xlsx, BoardIF.SchDoc, BoardIF.kicad_sch, Board_connection.kicad_sch, CAN_TxRx.SchDoc, CAN_TxRx.kicad_sch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]
2026-05-13 change can bitrate to 125
    changed the can bitrate to 125k
    [drive_current.csv]
2026-06-03 Add thermistor reading support in firmware and logger
2026-06-09 Set ADC sampling time to max (239.5 cyc)
2026-07-02 Add sampling for thermistor
