UM-Battery-Control-Group/LDC_Dual_Can/(notices)

Notices in the files:
Core/Src/main.c:
Copyright (c) 2024 STMicroelectronics.
All rights reserved.
This software is licensed under terms that can be found in the LICENSE file
parts and their libraries:
COPYRIGHT: Copyright (C) 2023 Ultra Librarian. All rights reserved.
